AcrylicEater/Sahara/Software/Software plan.pdf

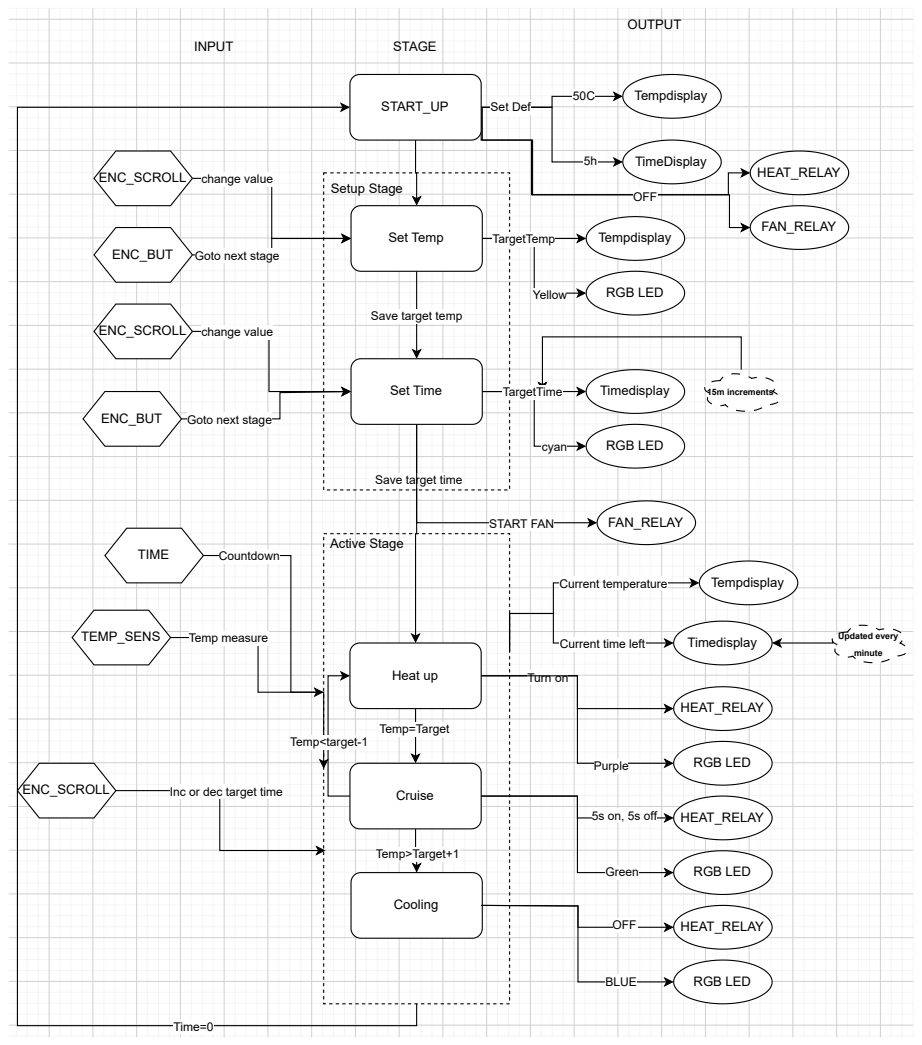
[picture p3: page 1]
Current temperature; Time=0; START_UP; Set Def; INPUT; STAGE; OUTPUT; Tempdisplay; TimeDisplay; FAN_RELAY; HEAT_RELAY; RGB LED; ENC_SCROLL; change value; ENC_BUT; Goto next stage; TEMP_SENS; Temp measure; TIME; Countdown; Yellow; Set Temp; Setup Stage; TargetTemp; START FAN; Set Time; cyan; TargetTime; Timedisplay; 15m increments; Active Stage; Turn on; Purple; Temp=Target; Heat up; Updated every; minute; 5s on, 5s off; Green; Temp<target-1; Temp>Target+1; Cruise; Cooling; OFF; BLUE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

Save target temp

Save target time

Current time left
