AcrylicEater/Sahara/Hardware/Sahara.kicad_pcb

## KiCad design Hardware/Sahara.kicad_pcb (2025-03-26)

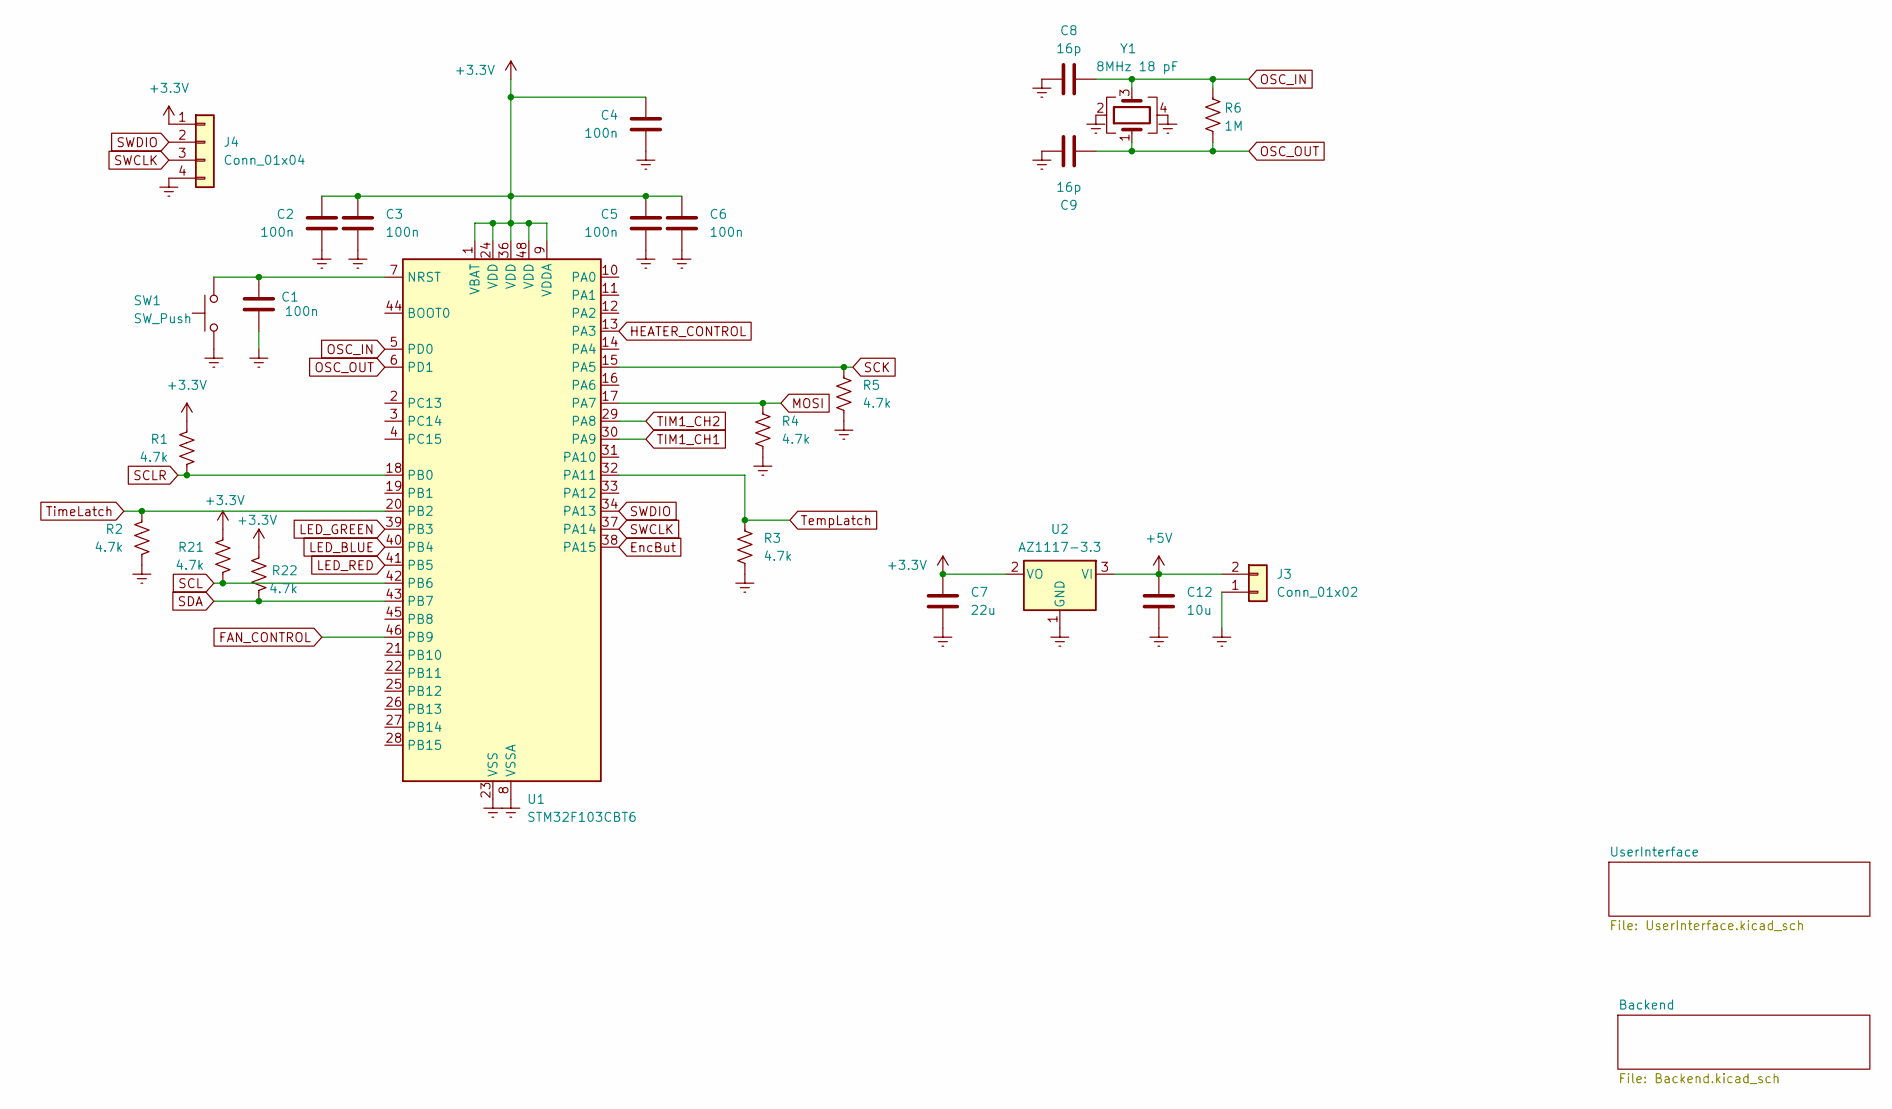
[picture p4: schematic Sahara.kicad_sch]

Parts:
C1, C2, C3, C4, C5, C6: 100n; C_0805_2012Metric
C7: 22u; C_0805_2012Metric
C8, C9: 16p; C_0805_2012Metric
C12: 10u; C_0805_2012Metric
J3: Conn_01x02; JST_XH_B2B-XH-AM_1x02_P2.50mm_Vertical
J4: Conn_01x04; JST_XH_B4B-XH-AM_1x04_P2.50mm_Vertical
R1, R2, R3, R4, R5, R21, R22: 4.7k; R_0805_2012Metric
R6: 1M; R_0805_2012Metric
SW1: SW_Push
U1: STM32F103CBT6; LQFP-48_7x7mm_P0.5mm
U2: AZ1117-3.3; SOT230P700X180-4N
Y1: 8MHz 18 pF; Crystal_SMD_TXC_7M-4Pin_3.2x2.5mm

Connections:
+3.3V: C2.1, C3.1, C4.1, C5.1, C6.1, C7.1, J4.1, R1.1, R21.1, R22.1, U1.1 (VBAT), U1.9 (VDDA), U1.24 (VDD), U1.36 (VDD), U1.48 (VDD), U2.2 (VO); also elsewhere on the board
+5V: C12.1, J3.2 (Pin_1), U2.3 (VI); also elsewhere on the board
Earth: C1.2, C2.2, C3.2, C4.2, C5.2, C6.2, C7.2, C8.1, C9.1, C12.2, J3.1 (Pin_2), J4.4, R2.2, R3.2, R4.2, R5.2, SW1.1, U1.8 (VSSA), U1.23 (VSS), U1.35 (VSS), U1.47 (VSS), U2.1 (GND), Y1.2, Y1.4; also elsewhere on the board
EncBut: U1.38 (PA15); also elsewhere on the board
FAN_CONTROL: U1.46 (PB9); also elsewhere on the board
HEATER_CONTROL: U1.13 (PA3); also elsewhere on the board
LED_BLUE: U1.40 (PB4); also elsewhere on the board
LED_GREEN: U1.39 (PB3); also elsewhere on the board
LED_RED: U1.41 (PB5); also elsewhere on the board
MOSI: R4.1, U1.17 (PA7); also elsewhere on the board
unnamed: C1.1, SW1.2, U1.7 (NRST)
OSC_IN: C8.2, R6.1, U1.5 (PD0), Y1.3
OSC_OUT: C9.2, R6.2, U1.6 (PD1), Y1.1
SCK: R5.1, U1.15 (PA5); also elsewhere on the board
SCL: R21.2, U1.42 (PB6); also elsewhere on the board
SCLR: R1.2, U1.18 (PB0); also elsewhere on the board
SDA: R22.2, U1.43 (PB7); also elsewhere on the board
SWCLK: J4.3, U1.37 (PA14)
SWDIO: J4.2, U1.34 (PA13)
TIM1_CH1: U1.30 (PA9); also elsewhere on the board
TIM1_CH2: U1.29 (PA8); also elsewhere on the board
TempLatch: R3.1, U1.32 (PA11); also elsewhere on the board
TimeLatch: R2.1, U1.20 (PB2); also elsewhere on the board

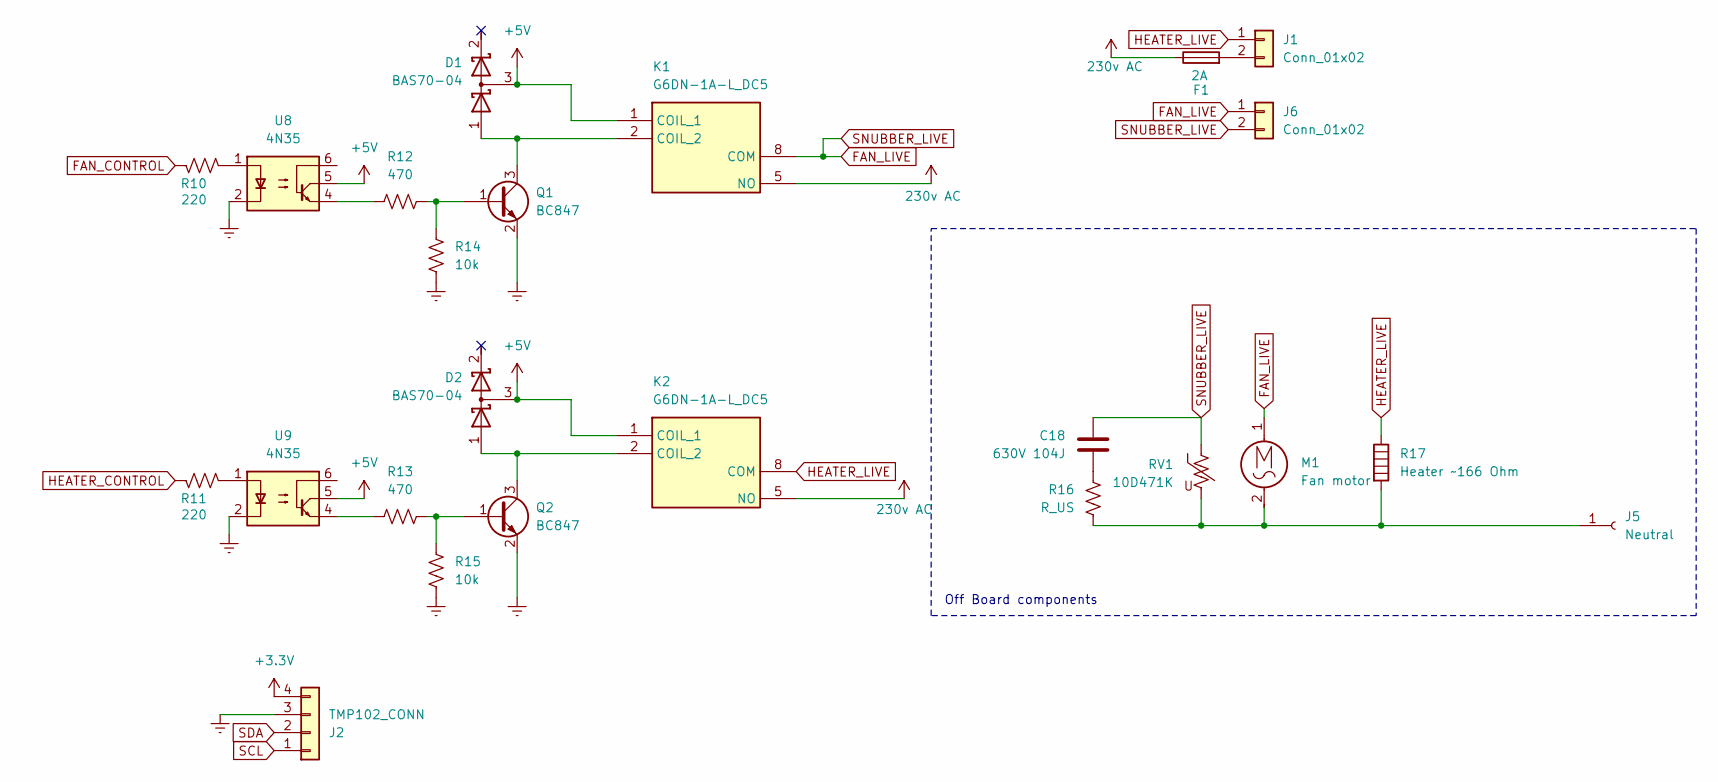
[picture p5: schematic Backend.kicad_sch]

Parts:
C18: 630V 104J
D1, D2: BAS70-04; SOT97P230X109-3N; Manufacturer_Part_Number BAS70-04; Mouser Part Number 821-BAS70-04
F1: 2A; WR-FSH_THT_2
J1, J6: Conn_01x02; TerminalBlock_Phoenix_PT-1,5-2-5.0-H_1x02_P5.00mm_Horizontal
J2: TMP102_CONN; JST_XH_B4B-XH-AM_1x04_P2.50mm_Vertical
J5: Neutral
K1, K2: G6DN-1A-L_DC5; G6DN-1A-L; Mouser Part Number 653-G6DN-1A-LDC5
M1: Fan motor
Q1, Q2: BC847; SOT-23
R10, R11: 220; R_0805_2012Metric
R12, R13: 470; R_0805_2012Metric
R14, R15: 10k; R_0805_2012Metric
R16: R_US
R17: Heater ~166 Ohm
RV1: 10D471K
U8, U9: 4N35; 4N35S

Connections:
230v AC: F1.1, K1.5 (NO), K2.5 (NO)
+3.3V: J2.4; also elsewhere on the board
+5V: D1.3 (common), D2.3 (common), K1.1 (COIL_1), K2.1 (COIL_1), U8.5, U9.5; also elsewhere on the board
Earth: J2.3, Q1.2 (E), Q2.2 (E), R14.1, R15.1, U8.2, U9.2; also elsewhere on the board
FAN_CONTROL: R10.2; also elsewhere on the board
FAN_LIVE: C18.1, J6.1, J6.2, K1.8 (COM), M1.1, RV1.1
HEATER_CONTROL: R11.2; also elsewhere on the board
HEATER_LIVE: J1.1, K2.8 (COM), R17.1
unnamed: C18.2, R16.1
unnamed: D1.1 (A), K1.2 (COIL_2), Q1.3 (C)
unnamed: D2.1 (A), K2.2 (COIL_2), Q2.3 (C)
unnamed: F1.2, J1.2
unnamed: J5.1, M1.2, R16.2, R17.2, RV1.2
unnamed: Q1.1 (B), R12.2, R14.2
unnamed: Q2.1 (B), R13.2, R15.2
unnamed: R10.1, U8.1
unnamed: R11.1, U9.1
unnamed: R12.1, U8.4
unnamed: R13.1, U9.4
SCL: J2.1; also elsewhere on the board
SDA: J2.2; also elsewhere on the board

Notes on the sheet:
Off Board components

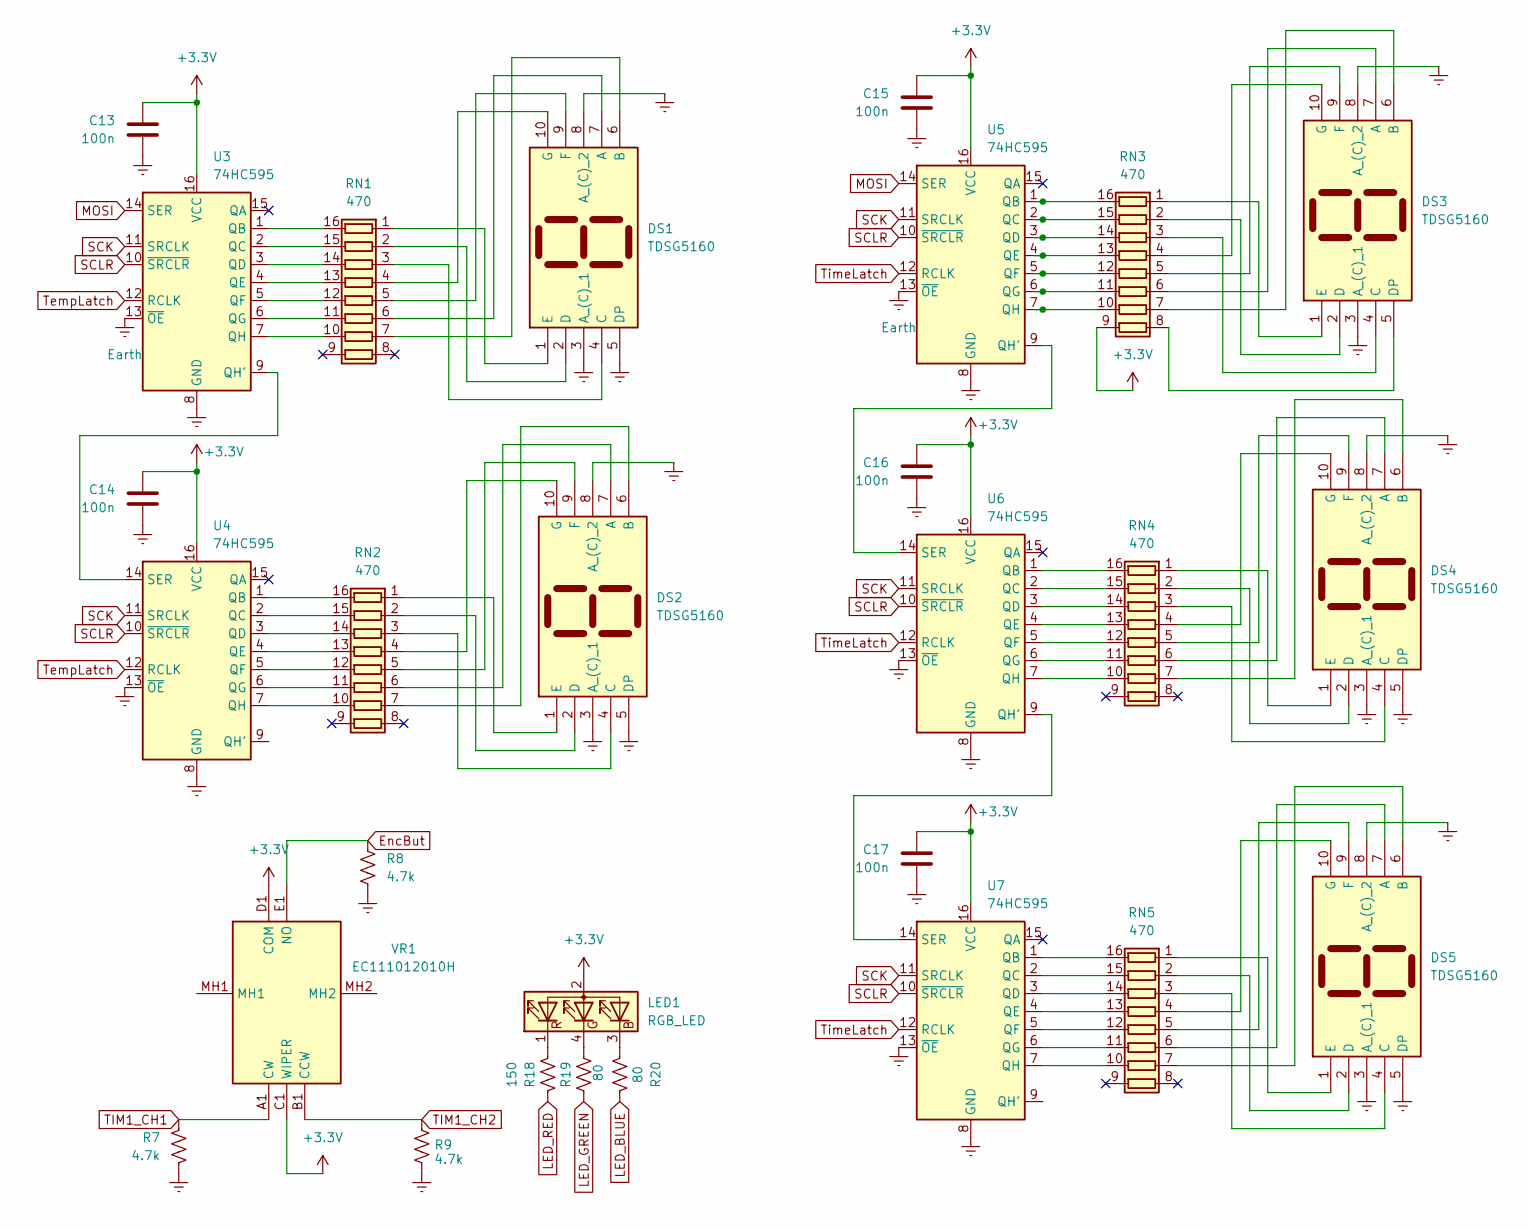
[picture p6: schematic UserInterface.kicad_sch]

Parts:
C13, C14, C15, C16, C17: 100n; C_0805_2012Metric
DS1, DS2, DS3, DS4, DS5: TDSG5160; Mouser Part Number 78-TDSG5160
LED1: RGB_LED; 5218559F; Manufacturer_Part_Number 521-8559F; Mouser Part Number 645-5218559F
R7, R8, R9: 4.7k; R_0805_2012Metric
R18: 150; R_0805_2012Metric
R19, R20: 80; R_0805_2012Metric
RN1, RN2, RN3, RN4, RN5: 470; EXB2HV_1
U3, U4, U5, U6, U7: 74HC595; SOIC127P600X175-16N
VR1: EC111012010H; Mouser Part Number 688-EC111012010H

Connections:
+3.3V: C13.1, C14.1, C15.1, C16.1, C17.1, LED1.2 (A), RN3.9 (R8.2), U3.16 (VCC), U4.16 (VCC), U5.16 (VCC), U6.16 (VCC), U7.16 (VCC), VR1.C1 (WIPER), VR1.D1 (COM); also elsewhere on the board
Earth: C13.2, C14.2, C15.2, C16.2, C17.2, DS1.3 (A_(C)_1), DS1.5 (DP), DS1.8 (A_(C)_2), DS2.3 (A_(C)_1), DS2.5 (DP), DS2.8 (A_(C)_2), DS3.3 (A_(C)_1), DS3.8 (A_(C)_2), DS4.3 (A_(C)_1), DS4.5 (DP), DS4.8 (A_(C)_2), DS5.3 (A_(C)_1), DS5.5 (DP), DS5.8 (A_(C)_2), R7.2, R8.2, R9.1, U3.8 (GND), U3.13 (~OE), U4.8 (GND), U4.13 (~OE), U5.8 (GND), U5.13 (~OE), U6.8 (GND), U6.13 (~OE), U7.8 (GND), U7.13 (~OE); also elsewhere on the board
EncBut: R8.1, VR1.E1 (NO); also elsewhere on the board
LED_BLUE: R20.1; also elsewhere on the board
LED_GREEN: R19.2; also elsewhere on the board
LED_RED: R18.2; also elsewhere on the board
MOSI: U3.14 (SER), U5.14 (SER); also elsewhere on the board
unnamed: DS1.7 (A), RN1.6 (R6.1)
unnamed: DS1.6 (B), RN1.7 (R7.1)
unnamed: DS1.4 (C), RN1.3 (R3.1)
unnamed: DS1.2 (D), RN1.2 (R2.1)
unnamed: DS1.1 (E), RN1.1 (R1.1)
unnamed: DS1.9 (F), RN1.5 (R5.1)
unnamed: DS1.10 (G), RN1.4 (R4.1)
unnamed: DS2.7 (A), RN2.6 (R6.1)
unnamed: DS2.6 (B), RN2.7 (R7.1)
unnamed: DS2.4 (C), RN2.3 (R3.1)
unnamed: DS2.2 (D), RN2.2 (R2.1)
unnamed: DS2.1 (E), RN2.1 (R1.1)
unnamed: DS2.9 (F), RN2.5 (R5.1)
unnamed: DS2.10 (G), RN2.4 (R4.1)
unnamed: DS3.7 (A), RN3.6 (R6.1)
unnamed: DS3.6 (B), RN3.7 (R7.1)
unnamed: DS3.4 (C), RN3.3 (R3.1)
unnamed: DS3.2 (D), RN3.2 (R2.1)
unnamed: DS3.5 (DP), RN3.8 (R8.1)
unnamed: DS3.1 (E), RN3.1 (R1.1)
unnamed: DS3.9 (F), RN3.5 (R5.1)
unnamed: DS3.10 (G), RN3.4 (R4.1)
unnamed: DS4.7 (A), RN4.6 (R6.1)
unnamed: DS4.6 (B), RN4.7 (R7.1)
unnamed: DS4.4 (C), RN4.3 (R3.1)
unnamed: DS4.2 (D), RN4.2 (R2.1)
unnamed: DS4.1 (E), RN4.1 (R1.1)
unnamed: DS4.9 (F), RN4.5 (R5.1)
unnamed: DS4.10 (G), RN4.4 (R4.1)
unnamed: DS5.7 (A), RN5.6 (R6.1)
unnamed: DS5.6 (B), RN5.7 (R7.1)
unnamed: DS5.4 (C), RN5.3 (R3.1)
unnamed: DS5.2 (D), RN5.2 (R2.1)
unnamed: DS5.1 (E), RN5.1 (R1.1)
unnamed: DS5.9 (F), RN5.5 (R5.1)
unnamed: DS5.10 (G), RN5.4 (R4.1)
unnamed: LED1.3 (BK), R20.2
unnamed: LED1.4 (GK), R19.1
unnamed: LED1.1, R18.1
unnamed: RN1.16 (R1.2), U3.1 (QB)
unnamed: RN1.15 (R2.2), U3.2 (QC)
unnamed: RN1.14 (R3.2), U3.3 (QD)
unnamed: RN1.13 (R4.2), U3.4 (QE)
unnamed: RN1.12 (R5.2), U3.5 (QF)
unnamed: RN1.11 (R6.2), U3.6 (QG)
unnamed: RN1.10 (R7.2), U3.7 (QH)
unnamed: RN2.16 (R1.2), U4.1 (QB)
unnamed: RN2.15 (R2.2), U4.2 (QC)
unnamed: RN2.14 (R3.2), U4.3 (QD)
unnamed: RN2.13 (R4.2), U4.4 (QE)
unnamed: RN2.12 (R5.2), U4.5 (QF)
unnamed: RN2.11 (R6.2), U4.6 (QG)
unnamed: RN2.10 (R7.2), U4.7 (QH)
unnamed: RN3.16 (R1.2), U5.1 (QB)
unnamed: RN3.15 (R2.2), U5.2 (QC)
unnamed: RN3.14 (R3.2), U5.3 (QD)
unnamed: RN3.13 (R4.2), U5.4 (QE)
unnamed: RN3.12 (R5.2), U5.5 (QF)
unnamed: RN3.11 (R6.2), U5.6 (QG)
unnamed: RN3.10 (R7.2), U5.7 (QH)
unnamed: RN4.16 (R1.2), U6.1 (QB)
unnamed: RN4.15 (R2.2), U6.2 (QC)
unnamed: RN4.14 (R3.2), U6.3 (QD)
unnamed: RN4.13 (R4.2), U6.4 (QE)
unnamed: RN4.12 (R5.2), U6.5 (QF)
unnamed: RN4.11 (R6.2), U6.6 (QG)
unnamed: RN4.10 (R7.2), U6.7 (QH)
unnamed: RN5.16 (R1.2), U7.1 (QB)
unnamed: RN5.15 (R2.2), U7.2 (QC)
unnamed: RN5.14 (R3.2), U7.3 (QD)
unnamed: RN5.13 (R4.2), U7.4 (QE)
unnamed: RN5.12 (R5.2), U7.5 (QF)
unnamed: RN5.11 (R6.2), U7.6 (QG)
unnamed: RN5.10 (R7.2), U7.7 (QH)
unnamed: U3.9 (QH'), U4.14 (SER)
unnamed: U5.9 (QH'), U6.14 (SER)
unnamed: U6.9 (QH'), U7.14 (SER)
SCK: U3.11 (SRCLK), U4.11 (SRCLK), U5.11 (SRCLK), U6.11 (SRCLK), U7.11 (SRCLK); also elsewhere on the board
SCLR: U3.10 (~SRCLR), U4.10 (~SRCLR), U5.10 (~SRCLR), U6.10 (~SRCLR), U7.10 (~SRCLR); also elsewhere on the board
TIM1_CH1: R7.1, VR1.A1 (CW); also elsewhere on the board
TIM1_CH2: R9.2, VR1.B1 (CCW); also elsewhere on the board
TempLatch: U3.12 (RCLK), U4.12 (RCLK); also elsewhere on the board
TimeLatch: U5.12 (RCLK), U6.12 (RCLK), U7.12 (RCLK); also elsewhere on the board

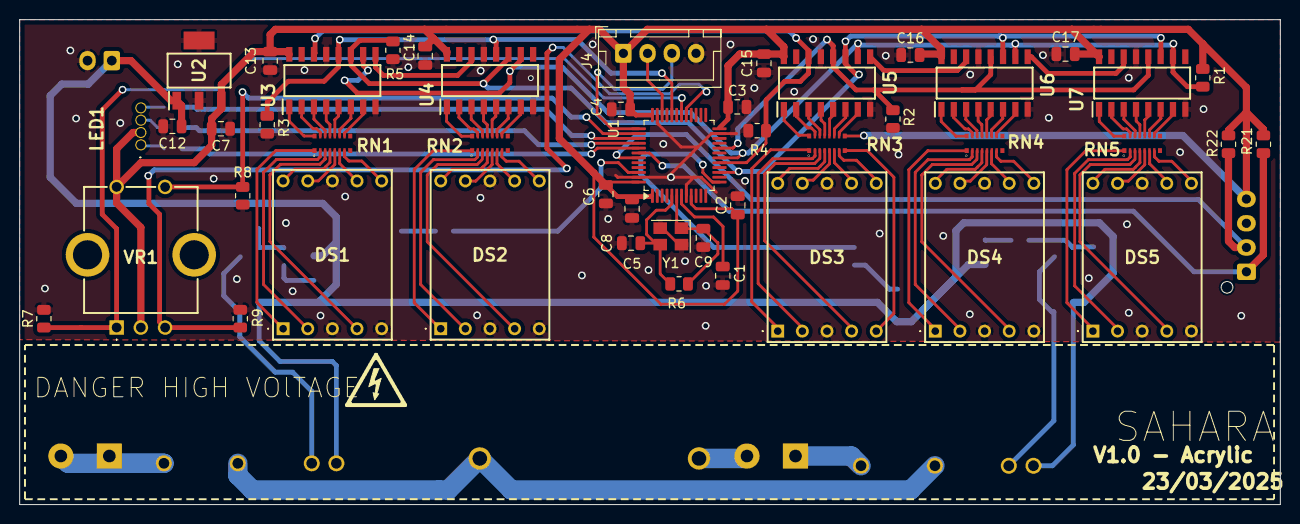
[picture p7: board Sahara.kicad_pcb from above]

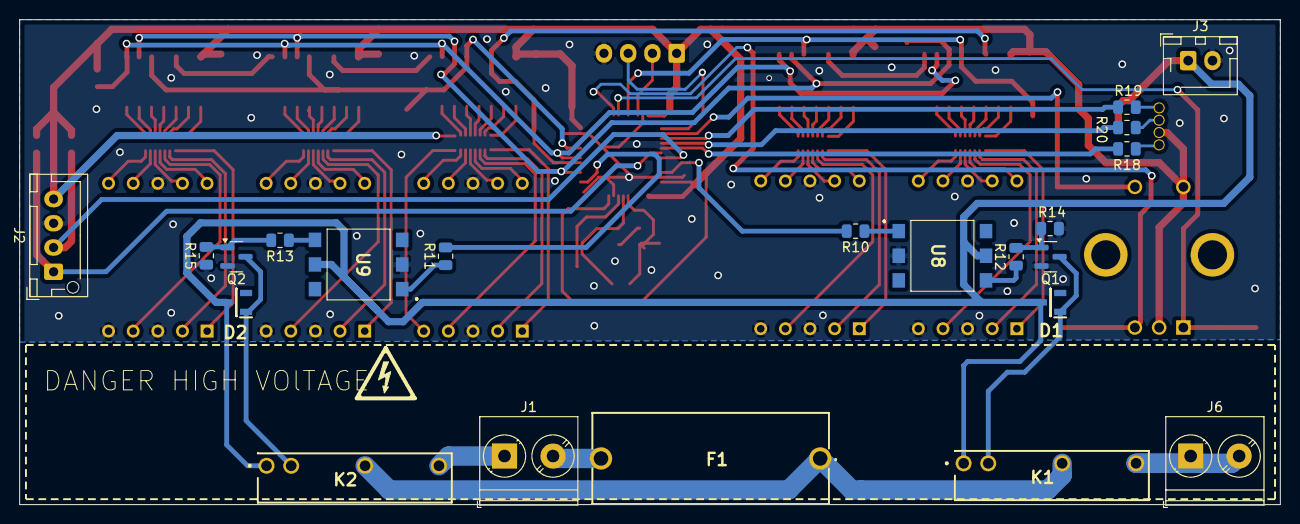
[picture p8: board Sahara.kicad_pcb from below]

Board: 2 copper layers, 130.0 x 50.0 mm, 69 parts (22 on the bottom side), 112 nets.
