AcrylicEater/Sahara/Software/Workspace/Core/Src/main.c

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
/* Includes ------------------------------------------------------------------*/
#include "main.h"

/* USER CODE BEGIN Includes */
#include "Output_manager.h"
#include "Input_manager.h"
/* USER CODE END Includes */

I2C_HandleTypeDef hi2c1;

RTC_HandleTypeDef hrtc;

SPI_HandleTypeDef hspi1;

TIM_HandleTypeDef htim1;
TIM_HandleTypeDef htim2;

/* USER CODE BEGIN PV */


static int16_t time = 0;
static float temp = 0.0;
static float targetTemp;
typedef enum {
    START_UP,
    INPUT_TEMP,
    INPUT_TIME,
    HEATUP,
    CRUISE,
    COOLDOWN,
    NUM_STAGES  // Total number of stages (used for array size)
} stages;

static stages stage;

typedef void (*StageFunction)(void);  // Function pointer type



/* USER CODE END PV */

void SystemClock_Config(void);
static void MX_GPIO_Init(void);
static void MX_SPI1_Init(void);
static void MX_TIM1_Init(void);
static void MX_RTC_Init(void);
static void MX_I2C1_Init(void);
static void MX_TIM2_Init(void);
/* USER CODE BEGIN 0 */

void HAL_TIM_PeriodElapsedCallback(TIM_HandleTypeDef *htim) {
    if (htim->Instance == TIM2) {  // Check if TIM2 triggered the interrupt
    	time--;
    	if(time<0){
    		stage=START_UP;
    		return;
    	}
    	displayTime(time);
    }
}

void start_up(){
	HAL_TIM_Base_Stop_IT(&htim2);
	setRelay(HEATER, 0);
	setRelay(FAN, 0);
	displayColor(BLACK);

	targetTemp = 50.0;
	time = 4*60 + 30;

	displayNumber((int)targetTemp, TEMP);
	displayTime(time);

	stage = INPUT_TEMP;
}

void input_temp(){
	displayColor(YELLOW);
	if(readEncoder(3)==HIGHER){
		targetTemp++;
	}
	if(readEncoder(3)==LOWER){
		targetTemp--;
	}
	displayNumber((int)targetTemp, TEMP);
	if (HAL_GPIO_ReadPin(EncBut_GPIO_Port, EncBut_Pin)==1){
		stage = INPUT_TIME;
	}
}

void input_time(){
	displayColor(CYAN);
	if(readEncoder(3)==HIGHER){
		time+=15;
	}
	if(readEncoder(3)==LOWER||time!=15){
		time-=15;
	}
	displayNumber((int)targetTemp, TEMP);
	if (HAL_GPIO_ReadPin(EncBut_GPIO_Port, EncBut_Pin)==1){
		stage = INPUT_TIME;
	}
}

void heatup(){

}

void cruise(){

}

void cooldown(){

}

StageFunction stageHandlers[NUM_STAGES] = {
    start_up,   // START_UP
    input_temp, // INPUT_TEMP
    input_time, // INPUT_TIME
    heatup,     // HEATUP
    cruise,     // CRUISE
    cooldown    // COOLDOWN
};

void set_alarm(uint8_t min)
{
    RTC_TimeTypeDef sTime = {0};  // Correct structure
    RTC_AlarmTypeDef sAlarm = {0}; // Keep sAlarm for setting alarm

    // Get the current time
    HAL_RTC_GetTime(&hrtc, &sTime, RTC_FORMAT_BIN);

    // Set the alarm time based on current time
    sAlarm.AlarmTime.Hours = sTime.Hours;
    sAlarm.AlarmTime.Minutes = sTime.Minutes;
    sAlarm.AlarmTime.Seconds = sTime.Seconds + min;
	sAlarm.Alarm = RTC_ALARM_A;
	if (HAL_RTC_SetAlarm_IT(&hrtc, &sAlarm, RTC_FORMAT_BIN) != HAL_OK)
	{
		Error_Handler();
	}
}

/* USER CODE END 0 */

/**
  * @brief  The application entry point.
  * @retval int
  */
int main(void)
{

  /* MCU Configuration--------------------------------------------------------*/

  /* Reset of all peripherals, Initializes the Flash interface and the Systick. */
  HAL_Init();

  /* Configure the system clock */
  SystemClock_Config();

  /* Initialize all configured peripherals */
  MX_GPIO_Init();
  MX_SPI1_Init();
  MX_TIM1_Init();
  MX_RTC_Init();
  MX_I2C1_Init();
  MX_TIM2_Init();
  /* USER CODE BEGIN 2 */

  setupTMP102();
  setupEncoder();
  stage = START_UP;

  /* USER CODE END 2 */

  /* Infinite loop */
  /* USER CODE BEGIN WHILE */

  //HAL_Delay(1000);
  while (1)
  {
	  stageHandlers[stage]();

	  /*
	   * if(HAL_I2C_IsDeviceReady(&hi2c1, (uint16_t)(TMP102_ADR<<1), 3, 25)==HAL_OK){
		  DisplayColor(GREEN);
	  }else{
		  DisplayColor(RED);
	  }
	  HAL_Delay(500);
	  if(timeState==0){
	  HAL_GPIO_WritePin(GPIOB, Fan_Relay_Pin, 0);
	  DisplayColor(CYAN);
	  EncRaw = __HAL_TIM_GET_COUNTER(&htim1);
	  if (EncRaw>=3+OldEncRaw){
		  count+=1;
		  OldEncRaw=EncRaw;
	  }
	  if (EncRaw<=OldEncRaw-3){
		  if(count!=0){
			  count-=1;
		  }
		  OldEncRaw=EncRaw;

	  }
	  DisplayNumber(count);
	  if (HAL_GPIO_ReadPin(EncBut_GPIO_Port, EncBut_Pin)==1){
		  DisplayColor(YELLOW);
		  timeState=1;
		  HAL_GPIO_WritePin(GPIOB, Fan_Relay_Pin, 1);
		  time = count;
		  set_alarm(1);
	  }
	  }
	*/






    /* USER CODE END WHILE */

    /* USER CODE BEGIN 3 */
  }
  /* USER CODE END 3 */
}

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
/* USER CODE BEGIN 4 */

/*
void HAL_RTC_AlarmAEventCallback(RTC_HandleTypeDef *hrtc)
{

  DisplayNumber(time,TIME);
  if(time==0){
	  timeState=0;
  }else{
	  time-=1;
	  set_alarm(1);
  }

}
*/
/* USER CODE END 4 */
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
