AcrylicEater/Sahara/Software/Workspace/Sahara.ioc

Mcu.UserName=STM32F103CBTx
PA13.Signal=SYS_JTMS-SWDIO
PA14.Signal=SYS_JTCK-SWCLK
PA15.GPIO_Label=EncBut
PA15.Signal=GPIO_Input
PA3.GPIO_Label=HEATER_RELAY
PA3.Signal=GPIO_Output
PA5.Signal=SPI1_SCK
PA7.Signal=SPI1_MOSI
PA8.Signal=S_TIM1_CH1
PA9.Signal=S_TIM1_CH2
PB0.GPIO_Label=SRCLR
PB0.Signal=GPIO_Output
PB10.GPIO_Label=TEMP_LATCH
PB10.Signal=GPIO_Output
PB2.GPIO_Label=TIME_LATCH
PB2.Signal=GPIO_Output
PB3.GPIO_Label=GREEN_LED
PB3.Signal=GPIO_Output
PB4.GPIO_Label=BLUE_LED
PB4.Signal=GPIO_Output
PB5.GPIO_Label=RED_LED
PB5.Signal=GPIO_Output
PB6.Signal=I2C1_SCL
PB7.Signal=I2C1_SDA
PB9.GPIO_Label=FAN_RELAY
PB9.Signal=GPIO_Output
PD0-OSC_IN.Signal=RCC_OSC_IN
PD1-OSC_OUT.Signal=RCC_OSC_OUT
