AcrylicEater/Sahara/Software/Workspace/Core/Inc/main.h

#define HEATER_RELAY_Pin GPIO_PIN_3
#define HEATER_RELAY_GPIO_Port GPIOA
#define SRCLR_Pin GPIO_PIN_0
#define SRCLR_GPIO_Port GPIOB
#define TIME_LATCH_Pin GPIO_PIN_2
#define TIME_LATCH_GPIO_Port GPIOB
#define TEMP_LATCH_Pin GPIO_PIN_10
#define TEMP_LATCH_GPIO_Port GPIOB
#define EncBut_Pin GPIO_PIN_15
#define EncBut_GPIO_Port GPIOA
#define GREEN_LED_Pin GPIO_PIN_3
#define GREEN_LED_GPIO_Port GPIOB
#define BLUE_LED_Pin GPIO_PIN_4
#define BLUE_LED_GPIO_Port GPIOB
#define RED_LED_Pin GPIO_PIN_5
#define RED_LED_GPIO_Port GPIOB
#define FAN_RELAY_Pin GPIO_PIN_9
#define FAN_RELAY_GPIO_Port GPIOB
