AcrylicEater/Sahara/(commit log)

2025-03-11 initial commit of project files
    [Backend.kicad_sch, Sahara.kicad_pcb, Sahara.kicad_sch, UserInterface.kicad_sch]
2025-03-11 schematic update
    [Backend.kicad_sch, Sahara.kicad_sch]
2025-03-12 Safety features on mains voltage
    [Backend.kicad_sch, Sahara.kicad_sch]
2025-03-19 added footprints
    [Backend.kicad_sch, Sahara.kicad_pcb, Sahara.kicad_sch, UserInterface.kicad_sch]
2025-03-23 Added temperature sensor and I2C setup, started PCB layout
    [Backend.kicad_sch, Sahara.kicad_pcb, Sahara.kicad_sch, UserInterface.kicad_sch]
2025-03-25 Software stuff
    [Sahara.kicad_pcb, Sahara.kicad_sch]
2025-03-26 Almost finished PCB
    [Sahara.kicad_pcb, Sahara.kicad_sch, UserInterface.kicad_sch]
2025-03-28 slight schematic update, finished pcb(for now)
    [Sahara.kicad_sch, UserInterface.kicad_sch]
